purduehackers/door-opener/README.md

# door-opener

🔑 Passport-based access control & door opener for Hack Night.

[Demo](https://youtu.be/31aA09y7xFA)

- [Documentation](./docs/README.md)
