purduehackers/door-opener/docs/hardware/README.md

# Hardware

This directory documents the hardware for `door-opener`.

## [v2](./v2/README.md)

This is the recommended build for `door-opener`. CAD files are
[available here](../../cad/v2/).

## [v1](./v1/README.md)

This is not recommended anymore and kept only for maintenance purposes. If you
need to work on `door-opener-v1`, view this documentation. CAD files are not
available.
