purduehackers/door-opener/docs/hardware/v2/README.md

# door-opener-v2

## External

v2 is comprised of a more simplified design compared to v1, with the back plate
that is designed to slide out entirely. This allows for easier access during
maintenance.

The screw holding the back plate to the enclosure is an M3, with a length of 20
mm. The screw head is a Torx T10.

Once removed, the Raspberry Pi with the touchscreen module should be visible.
The red NFC module should be to the bottom left, and the camera module should be
to the bottom right.

The touchscreen module should be held in with 4x M2.5 screws, 10 mm in length.
The screw head is a Torx T8.

The red PN532 NFC module should be held in with 2x M3 screws, 6.7 mm in length.
The screw head is a Philips PH1.

The camera module should be held in with 4x M2 screws, 5.8 mm in length. The
screw head is a Torx T6.

If building a new enclosure, you should also insert new heat set inserts. The
dimensions are as follows:

- NFC module and back plate standoff: M3, 3 mm height, 3x
- Raspberry Pi camera module standoff: M2, 2.5 mm height, 4x

## BOM

| Name | URL | Notes |
|---|-----|---|
| Raspberry Pi 5 | Anywhere in stock sadly | |
| 5-inch Touchscreen | [Amazon](https://www.amazon.com/dp/B0CXTFN8K9) | |
| PN532 NFC module | [Amazon](https://www.amazon.com/dp/B01I1J17LC) | |
| Raspberry Pi Camera Module 3 12 MP 120 Degree Wide Angle Lens | [Adafruit](https://www.adafruit.com/product/5658) | |
| 3x M3 3 mm Heat Set Insert | | |
| 4x M2 2.5 mm Heat Set Insert | | |
| 1x M3 20 mm screw | | |
| 4x M2.5 10 mm screws | | |
| 2x M3 6.7 mm screws | | |
| 4x M2 5.8 mm screws | | |

Notes:
- Raspberry Pi 5 should be usable with ? GB RAM variant.

## [Assembly Instructions](./assembly.md)
