purduehackers/door-opener/cad/v2/BackPlate_v7.stp

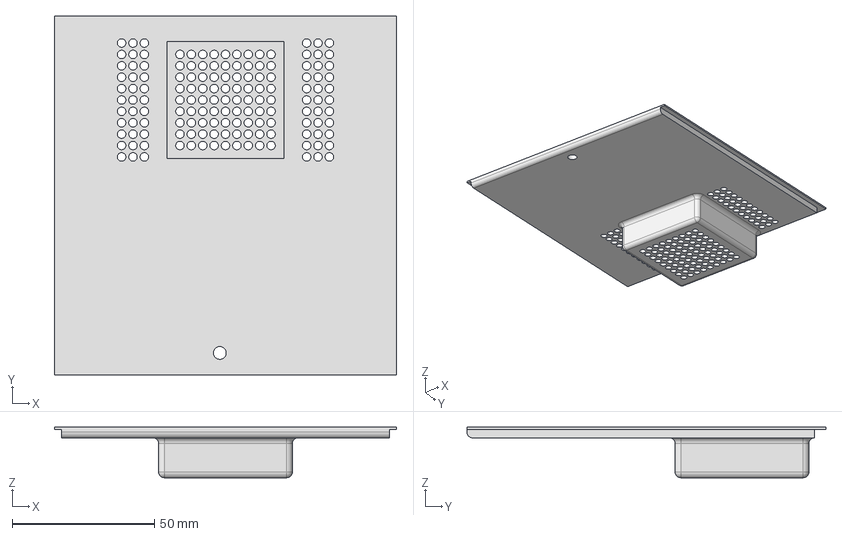
[picture p1: CAD file, 2026-04-21]
cad/v2/BackPlate_v7.stp
120.3 x 126.1 x 17.8 mm
