purduehackers/door-opener/cad/v2/Enclosure_v7.stp

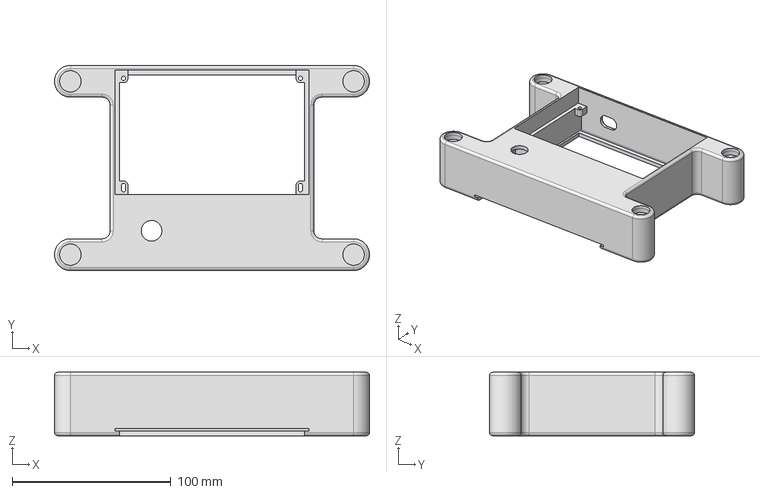
[picture p2: CAD file, 2026-04-06]
cad/v2/Enclosure_v7.stp
198.3 x 129.1 x 40.0 mm
