purduehackers/door-opener/cad/v2/BackPlate_v3.stp

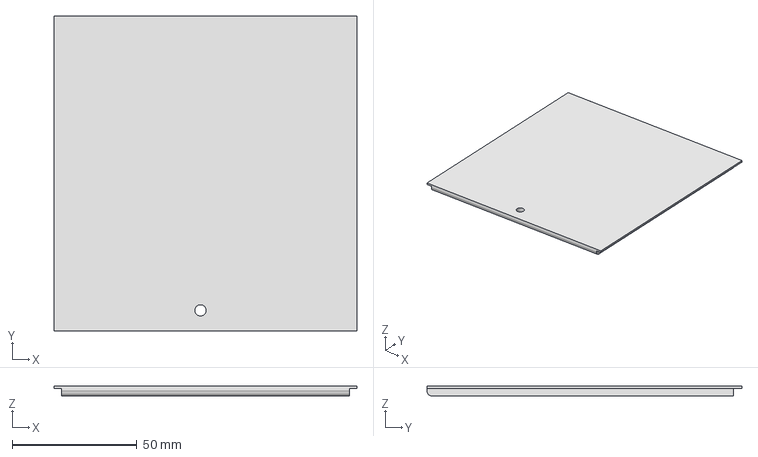
[picture p3: CAD file, 2026-03-07, an earlier design]
cad/v2/BackPlate_v3.stp
121.3 x 126.1 x 4.00 mm
