purduehackers/door-opener/(list of files, cad)

Other CAD files:
cad/v2/Enclosure_v5.stp
cad/v2/Enclosure_v4.stp
cad/v2/BackPlate.ipt
cad/v2/Enclosure.ipt
cad/v2/door-opener-v2-enclosure.iam
cad/v2/door-opener-v2-enclosure.ipt
