purduehackers/door-opener/src/websocket.rs

use std::{env, time::Duration};

use async_tungstenite::tungstenite::Error;
use async_tungstenite::{
    WebSocketSender,
    tokio::{ConnectStream, connect_async},
    tungstenite::{Bytes, Message},
};
use futures::prelude::*;

use tokio::time::sleep;
use tracing::{error, info, warn};

use crate::camera::capture_photo;

#[derive(Debug, serde::Deserialize, serde::Serialize)]
#[serde(tag = "type")]
enum WebSocketMessage {
    Open,
    OpenAck,
    CapturePhoto,
    PhotoResult { data: String },
}

async fn handle_message<F>(
    write: &mut WebSocketSender<ConnectStream>,
    msg: Option<Result<Message, Error>>,
    open: &mut F,
) -> Result<(), ()>
where
    F: FnMut() + Send + 'static,
{
    match msg {
        Some(Ok(Message::Text(t))) => {
            if let Ok(msg) = serde_json::from_str(t.as_ref()) {
                match msg {
                    WebSocketMessage::Open => {
                        open();
                        let res = write
                            .send(Message::Text(
                                serde_json::to_string(&WebSocketMessage::OpenAck)
                                    .unwrap()
                                    .into(),
                            ))
                            .await;
                        if let Err(e) = res {
                            error!(error = ?e, "failed to send open ack");
                        }
                    }
                    WebSocketMessage::CapturePhoto => {
                        let photostring = capture_photo();
                        if let Ok(photostring) = photostring {
                            let res = write
                                .send(Message::Text(
                                    serde_json::to_string(&WebSocketMessage::PhotoResult {
                                        data: photostring,
                                    })
                                    .unwrap()
                                    .into(),
                                ))
                                .await;
                            if let Err(e) = res {
                                error!(error = ?e, "failed to send photo result");
                            }
                        } else {
                            error!(error = ?photostring, "failed to capture photo");
                        }
                    }
                    WebSocketMessage::OpenAck | WebSocketMessage::PhotoResult { .. } => {
                        // We send those and we should never receive them from the server
                        unreachable!("Server sent invalid sender-only packets!");
                    }
                }
            }
        }
        Some(Ok(Message::Ping(_) | Message::Pong(_))) => {}
        Some(Err(e)) => error!(error = ?e, "received websocket error"),
        None => {
            return Err(());
        }
        _ => warn!(message = ?msg, "unsupported websocket message received"),
    }
    Ok(())
}

/// Websocket entry
///
/// # Panics
///
/// Will panic if there is no API key found
pub async fn ws_entry<F>(mut open: F)
where
    F: FnMut() + Send + 'static,
{
    let websocket_url = "wss://api.purduehackers.com/phonebell/door-opener";

    loop {
        let (socket, _resp) = match connect_async(websocket_url).await {
            Ok(x) => {
                info!(url = websocket_url, "connected to websocket");
                x
            }
            Err(e) => {
                warn!(
                    url = websocket_url,
                    retry_in_secs = 5,
                    error = %e,
                    "failed to connect to API websocket; retrying"
                );
                sleep(Duration::from_secs(5)).await;
                continue;
            }
        };

        let (mut write, mut read) = socket.split();

        write
            .send(Message::Text(
                env::var("DOOR_OPENER_API_KEY")
                    .expect("door opener API key")
                    .into(),
            ))
            .await
            .expect("write auth");

        loop {
            tokio::select! {
                () = sleep(Duration::from_secs(25)) => {
                    write.send(Message::Ping(Bytes::default())).await.expect("ping");
                }
                msg = read.next() => {
                    let res = handle_message(&mut write, msg, &mut open).await;
                    if res.is_err() {
                        break;
                    }
                }
            }
        }

        warn!("websocket connection closed");
    }
}
