purduehackers/door-opener/src/updater.rs

#![cfg(not(debug_assertions))]
use std::env;

use std::error::Error;
use tokio::fs::File;
use tokio::io::AsyncWriteExt;

use reqwest::Client;
use semver::Version;
use serde_json::Value;

use self_replace::self_replace;

type Result<T> = std::result::Result<T, Box<dyn Error>>;

/// Checks and performs updates, returns true if an update was performed
pub async fn update_check() -> bool {
    // Get the latest release on GitHub
    let latest_version = Version::parse(
        get_latest_version()
            .await
            .unwrap_or_else(|e| {
                eprintln!("Failed to fetch latest version from GitHub!");
                sentry::capture_error(&*e);
                String::from("0.0.0")
            })
            .as_str(),
    )
    .unwrap();
    let current_version = Version::parse(env!("CARGO_PKG_VERSION")).unwrap();

    // Compare our version string
    if latest_version > current_version {
        println!(
            "We are out of date; the latest version is {} and we are at {}",
            latest_version, current_version
        );
        let update_result = perform_update().await;
        match update_result {
            Ok(()) => {
                println!("Update successful!");
                true
            }
            Err(e) => {
                eprintln!("Update failed: {e}");
                false
            }
        }
    } else {
        println!("No update required; current version is {}", current_version);
        false
    }
}

fn get_client() -> Result<Client> {
    Ok(reqwest::Client::builder()
        .user_agent("door-opener")
        .build()?)
}

/// Gets the latest version number from GitHub
async fn get_latest_version() -> Result<String> {
    let client = get_client()?;
    let response = client
        .get("https://api.github.com/repos/purduehackers/door-opener/releases/latest")
        .send()
        .await?;

    let json: Value = response.json().await?;

    let tag_name = json
        .get("tag_name")
        .ok_or("missing tag_name")?
        .as_str()
        .ok_or("invalid type for tag_name")?
        .to_string();

    Ok(tag_name)
}

fn get_arch_suffix() -> Result<&'static str> {
    match env::consts::ARCH {
        "aarch64" => Ok("aarch64"),
        arch => Err(format!("unsupported architecture: {}", arch).into()),
    }
}

async fn perform_update() -> Result<()> {
    // Where are we?
    let current_executable_path = env::current_exe().unwrap();

    // Grab artifact from latest release matching our architecture
    let arch = get_arch_suffix()?;
    let url = format!(
        "https://github.com/purduehackers/door-opener/releases/latest/download/openerapp_{}",
        arch
    );
    let client = get_client()?;
    let response = client.get(&url).send().await?;
    let artifact = response.bytes().await?.to_vec();

    // Save file temporarily
    let temp_path = current_executable_path.with_extension("tmp");
    let mut temp_file = File::create(&temp_path).await?;
    temp_file.write_all(&artifact).await?;

    self_replace(temp_path)?;

    Ok(())
}
