purduehackers/door-opener/src/enums.rs

#[derive(Debug, Clone, Copy, Eq, PartialEq, Default)]
pub enum AuthState {
    #[default]
    Idle = 0,
    Pending = 1,
    Valid = 2,
    Invalid = 3,
    NetError = 4,
    NFCError = 5,
    DoorHWNotReady = 6,
}
