purduehackers/door-opener/src/gui/passport/mod.rs

use macroquad::prelude::*;

use super::svg;

use super::colors::{BLACK_BG, GREEN_CL, RED_CL, YELLOW_ACCENT};
use crate::AuthState;

const PASSPORT_EMBLEM: &[u8] = include_bytes!("../assets/passport-emblem.svg");
const LOADING_SPINNER: &[u8] = include_bytes!("../assets/loading-spinner.svg");

pub struct PassportData {
    logo_texture: Texture2D,
    loading_spinner_texture: Texture2D,
    current_spinner_colour: Color,
    current_spinner_cutout_opacity: f32,
    current_x: f32,
    current_y: f32,
    last_state: AuthState,
    current_animation_time: f32,
    last_final_x: f32,
    last_final_y: f32,
}

/// Initialize passport data
///
/// # Panics
///
/// Will panic if the textures cannot be loaded
#[must_use]
pub fn initialise_passport() -> PassportData {
    let logo_texture = svg::svg_to_texture(
        String::from_utf8(PASSPORT_EMBLEM.to_vec())
            .unwrap()
            .as_str(),
    );
    let loading_spinner_texture = svg::svg_to_texture(
        String::from_utf8(LOADING_SPINNER.to_vec())
            .unwrap()
            .as_str(),
    );

    PassportData {
        logo_texture,
        loading_spinner_texture,
        current_spinner_colour: YELLOW_ACCENT(255),
        current_spinner_cutout_opacity: 0.0,
        current_x: 0.0,
        current_y: 0.0,
        last_state: AuthState::Idle,
        current_animation_time: 0.0,
        last_final_x: 0.0,
        last_final_y: 0.0,
    }
}

#[allow(clippy::cast_possible_truncation)]
pub fn draw_passport(x: f32, y: f32, state: AuthState, passport_data: &mut PassportData) {
    let delta_time: f32 = get_frame_time();
    let loading_spinner_angle = (get_time() * 3.0) as f32;

    if state != passport_data.last_state {
        passport_data.last_state = state;
        passport_data.current_animation_time = 0.0;
        passport_data.last_final_x = passport_data.current_x;
        passport_data.last_final_y = passport_data.current_y;
    }

    update_passport_position(x, y, state, passport_data);

    passport_data.current_animation_time =
        f32::clamp(passport_data.current_animation_time + delta_time, 0.0, 2.0);

    // Passport box should fit within current screen
    let passport_side_length = screen_width().min(screen_height());
    let inner_passport_side_length = passport_side_length - 20.0;

    draw_rectangle(
        passport_data.current_x - passport_side_length / 2.0,
        passport_data.current_y - passport_side_length / 2.0,
        passport_side_length,
        passport_side_length,
        YELLOW_ACCENT(255),
    );
    draw_rectangle(
        passport_data.current_x - inner_passport_side_length / 2.0,
        passport_data.current_y - inner_passport_side_length / 2.0,
        inner_passport_side_length,
        inner_passport_side_length,
        BLACK_BG(255),
    );

    update_spinner_state(state, delta_time, passport_data);

    draw_texture_ex(
        &passport_data.logo_texture,
        passport_data.current_x - (passport_side_length / 2.0),
        passport_data.current_y - (passport_side_length / 2.0),
        YELLOW_ACCENT(255),
        DrawTextureParams {
            dest_size: Some(vec2(passport_side_length, passport_side_length)),
            ..Default::default()
        },
    );

    draw_loading_spinner(loading_spinner_angle, passport_data);
}

fn update_passport_position(x: f32, y: f32, state: AuthState, passport_data: &mut PassportData) {
    let curved_x = match state {
        AuthState::Idle => None,
        AuthState::Pending => {
            let linear_x = f32::clamp(passport_data.current_animation_time, 0.0, 1.0);
            Some(ease_in_out(linear_x))
        }
        _ => {
            let linear_x = passport_data.current_animation_time - 1.0;
            if linear_x >= 0.0 {
                Some(ease_in_out(linear_x))
            } else {
                Some(0.0)
            }
        }
    };

    if let Some(curve) = curved_x {
        passport_data.current_x = super::float32_lerp(passport_data.last_final_x, x, curve);
        passport_data.current_y = super::float32_lerp(passport_data.last_final_y, y, curve);
    } else {
        passport_data.current_x = x;
        passport_data.current_y = y;
    }
}

fn update_spinner_state(state: AuthState, delta_time: f32, passport_data: &mut PassportData) {
    let target_opacity = if matches!(state, AuthState::Pending) {
        0.0
    } else {
        1.0
    };

    passport_data.current_spinner_cutout_opacity = super::float32_lerp(
        passport_data.current_spinner_cutout_opacity,
        target_opacity,
        delta_time * 10.0,
    );

    let target_colour = match state {
        AuthState::Idle | AuthState::Pending => YELLOW_ACCENT(255),
        AuthState::Valid => GREEN_CL,
        AuthState::Invalid
        | AuthState::NetError
        | AuthState::NFCError
        | AuthState::DoorHWNotReady => RED_CL,
    };

    passport_data.current_spinner_colour = super::colour_lerp(
        passport_data.current_spinner_colour,
        target_colour,
        delta_time * 10.0,
    );
}

fn draw_loading_spinner(loading_spinner_angle: f32, passport_data: &PassportData) {
    let passport_side_length = screen_width().min(screen_height());
    let spinner_center_x = passport_data.current_x - (passport_side_length / 2.0);
    let spinner_center_y = passport_data.current_y - (passport_side_length / 2.0);

    draw_texture_ex(
        &passport_data.loading_spinner_texture,
        spinner_center_x,
        spinner_center_y,
        Color {
            r: passport_data.current_spinner_colour.r,
            g: passport_data.current_spinner_colour.g,
            b: passport_data.current_spinner_colour.b,
            a: passport_data.current_spinner_cutout_opacity,
        },
        DrawTextureParams {
            dest_size: Some(vec2(passport_side_length, passport_side_length)),
            rotation: loading_spinner_angle,
            flip_x: true,
            flip_y: true,
            ..Default::default()
        },
    );

    draw_texture_ex(
        &passport_data.loading_spinner_texture,
        spinner_center_x,
        spinner_center_y,
        passport_data.current_spinner_colour,
        DrawTextureParams {
            dest_size: Some(vec2(passport_side_length, passport_side_length)),
            rotation: loading_spinner_angle,
            ..Default::default()
        },
    );
}

fn ease_in_out(linear_x: f32) -> f32 {
    -2.0 * (linear_x * linear_x * linear_x) + 3.0 * (linear_x * linear_x)
}
