purduehackers/door-opener/(commit log)

2023-12-14 more idiomatic rust in message receiving -- handle all errors
    [mod.rs]
2024-01-13 fixed an nfc connection issue
    [mod.rs]
2024-01-14 implemented proper nfc polling and the LED controller
2024-02-28 some final optimizations and error checking
    [mod.rs]
2024-12-10 Added a tool to interpret LX-16A servo commands on an rp2040-based microcontroller
2025-09-27 fix: use POST instead of GET
    This was changed in https://github.com/purduehackers/id/pull/12
    [mod.rs]
2025-09-27 feat: separate NFC and net error screens
    [mod.rs]
2025-09-27 fix: consume result
    Regression, oops
    [mod.rs]
2025-09-27 fix: temp print out errors
    [mod.rs]
2025-09-27 fix: change variable name
    [mod.rs]
2025-09-27 fix: add content-type header
    [mod.rs]
2025-09-27 fix: update NFC error message
    Too long, overflowed the text box
    [mod.rs]
2025-11-11 fix: enable vendored feature only for nfc1 on Windows
    Default features list includes `drivers`, which we do not need.
2025-11-11 fix: remove lifetimes
    Device no longer takes lifetimes in latest nfc1/nfc1-sys
    [mod.rs]
2025-11-12 fix: cargo clippy suggestions
    [mod.rs, timedvariable.rs]
2025-11-12 fix: remove dead code
    [mod.rs]
2025-11-12 fix: bubble up NFC device open error
    [mod.rs]
2025-11-15 fix: return reqwest error instead of hiding it
    cargo clippy suggestion
    [mod.rs]
2025-11-20 docs(hardware): add v1 screw positions image
2025-11-21 docs(hardware): add NFC module and wiring information
2026-01-23 build: switch to Rust edition 2024
2026-01-23 fix: remove unused ServoEmulator and lib
2026-01-26 fix(gui): remove LED controller comments
    [mod.rs]
2026-01-26 fix: add integer values to the enums for now
    We can remove them once we've gotten rid of all the magic
    numbers in the code
    [enums.rs]
2026-01-26 fix: remove unnecessary default match arm for passport color
    [mod.rs]
2026-01-26 fix: initialize servo controller on move instead of once
    [mod.rs]
2026-02-13 fix: remove unused imports
    grr @ImTheSquid >:(
    [main.rs, mod.rs]
2026-02-13 fix: all cargo clippy warnings
    [main.rs, mod.rs, timedvariable.rs]
2026-02-13 fix: look for nimble BLE devices as well
    for _some_ reason, it advertises as nimble despite us setting the
    ada-pusher name. i don't know why and I can't figure out why right now,
    just patch
2026-02-14 fix: remove unused imports
    [main.rs]
2026-02-14 fix: clean up debug messages
    [mod.rs]
2026-02-14 fix: remove unused import
    [mod.rs]
2026-02-14 fix: remove unnecessary debug messages
    [mod.rs]
2026-02-14 fix: remove tokio init arguments
    Not needed, defaults are fine
    [main.rs]
2026-02-15 fix: visibility of updater
    [updater.rs]
2026-02-15 fix: import and await
    [main.rs]
2026-02-15 fix: properly gate all updater functions behind debug cfg
    [main.rs, updater.rs]
2026-02-18 refactor(gui): repeated error windows
    [mod.rs]
2026-02-18 fix(hardware): gate modules behind features
    [mod.rs]
2026-02-18 fix(hardware): use correct module specified with feature
    [mod.rs]
2026-02-18 refactor(gui): simplified error matching
    [mod.rs]
2026-02-20 fix!: append aarch64 arch name to built binary
    Updater will now look for binary corresponding to the current
    arch, but this is considered a breaking change and we should bump minor
    (0.x)
    [updater.rs]
2026-02-20 feat: retry door hardware init and show error in meantime
    [enums.rs, main.rs, mod.rs]
2026-02-20 fix: retry sending open command on fail
    [mod.rs]
2026-02-20 fix: re-init after multiple failed open attempts
    [mod.rs]
2026-02-21 fix(updater): add user agent to request
    [updater.rs]
2026-02-21 fix: remove unnecessary print
    [updater.rs]
2026-02-21 fix!: remove lx16a code, revert to pre-retry code
    Hotfix for hack night
    [main.rs, mod.rs]
2026-02-21 fix: add more debugging messages
    [mod.rs]
2026-02-21 fix: add updater debug message
    [main.rs]
2026-02-21 fix(updater): more debug messages
    [updater.rs]
2026-02-21 fix: add more debug messages
    [mod.rs]
2026-02-21 fix: actually check result of sending open command
    [mod.rs]
2026-02-21 fix: make blocking threads use spawn_blocking
    [main.rs]
2026-02-21 release: 0.4.6
    Try using separate threads for blocking calls
2026-02-23 fix: cargo clippy with pedantic ruleset
    [main.rs, mod.rs]
2026-02-23 fix: more cargo clippy suggestions
    [main.rs, mod.rs]
2026-02-23 fix: increase ping interval to 25 seconds
    [main.rs]
2026-03-02 fix: cargo clippy nest or pattern
    [main.rs]
2026-03-02 feat: add door-opener-v2 CAD models
    [BackPlate.ipt, Enclosure.ipt, door-opener-v2-enclosure.iam, door-opener-v2-enclosure.ipt]
2026-03-02 feat(cad): add initial v2 enclosure STEP drafts
    [BackPlate.step, Enclosure.step]
2026-03-02 fix: retry websocket connection on fail
    Fixes #16
    [main.rs]
2026-03-02 fix: rename steps in Inventor file
    [door-opener-v2-enclosure.ipt]
2026-03-02 fix(cad): rework enclosure (v2)
    Fixed the following:
    - Wall thickness increased to 3mm for better structural integrity
    - Suction cup nub thickness properly measured with ada-pusher
    [Enclosure.step, Enclosure_v2.stl, door-opener-v2-enclosure.iam, door-opener-v2-enclosure.ipt]
2026-03-04 refactor(cad): bring out screw post dist for RPi screen assembly
    [door-opener-v2-enclosure.ipt]
2026-03-04 fix(cad): shorten screw distance for RPi screen assembly
    69.1 mm -> 67.4 mm
    [door-opener-v2-enclosure.ipt]
2026-03-04 fix(cad): increase screen depth of RPi screen assembly
    11.6 mm to 13.6 mm
    Should help protect screen better in case it is dropped
    [door-opener-v2-enclosure.ipt]
2026-03-04 fix(cad): increase camera offset from front of enclosure
    Otherwise the lens protrudes from the enclosure and will probably
    break if dropped. Use acrylic or tape to prevent dust intrusion
    [door-opener-v2-enclosure.ipt]
2026-03-04 fix(cad): add fillets
    [door-opener-v2-enclosure.ipt]
2026-03-04 fix(cad): export v3
    Changes:
    - Fixed screw post distance in-between for RPi screen assembly
    - Inset RPi screen to protect against drops and cracks
    - Lengthened camera screw posts to not have camera protrude from
    enclosure
    - Added fillets for appropriate edges
    [BackPlate.ipt, BackPlate.step, BackPlate_v3.stl, Enclosure.ipt, Enclosure_v2.stl, Enclosure_v3.stl, door-opener-v2-enclosure.ipt]
2026-03-07 fix: replace updater logic with self_update
    Thanks to @ImTheSquid for the pointer
    [updater.rs]
2026-03-07 fix: bring back module re-init logic from before
    [main.rs, mod.rs]
2026-03-07 fix: unused argument warning in release builds
    [mod.rs]
2026-03-07 release: 0.5.0
    ## Changed
    - Websocket pings and pongs are no longer printed to the console
    - Door module will attempt re-initialization if connection fails
    - Try fixing updater again with self_update crate
    - Updated tokio to v1.50.0
    - Updated uuid to v1.22.0
    - General code cleanup
2026-03-07 fix: cargo clippy lint warnings
    [main.rs, mod.rs]
2026-03-07 fix(cad): give backplate some tolerance and create v3 export
    [BackPlate_v3.stp, door-opener-v2-enclosure.iam, door-opener-v2-enclosure.ipt]
2026-03-09 fix(cad): remove old BackPlate export file
    [BackPlate_v3.stl]
2026-03-09 fix(cad): remove tolerances from display side screw holes
    0.5mm off so the holes were not aligning. Remove them.
    [door-opener-v2-enclosure.ipt]
2026-03-09 fix(cad): offset screw holes of screen from top by 0.1mm
    [door-opener-v2-enclosure.ipt]
2026-03-09 docs(hw): finalize back plate screw dimensions
2026-03-09 fix: remove QR code and QR pointer
    We no longer use the doorbell and use phone bell instead
    [mod.rs]
2026-03-09 fix: add feature flag for NFC reader
    [mod.rs]
2026-03-09 fix: gate ada_pusher behind feature flag
    Having a dummy door module makes testing easier
    [mod.rs]
2026-03-09 fix(gui): update message to pick up phone bell
    [mod.rs]
2026-03-09 fix(gui): remove useless margins for all text
    We don't show the QR code anymore, so remove the useless
    hardcoded text margins
    [mod.rs]
2026-03-10 fix(gui): replace hardcoded values with const hardcodes
    Next step would be to remove them
    [mod.rs]
2026-03-10 fix(gui): tweak phone bell message
    [mod.rs]
2026-03-10 fix: allow for possible truncation for width and height
    [mod.rs]
2026-03-11 fix(cad): shorten RPi display assembly standoff depth
    Screws are 10 mm long, and the standoffs on the display assembly
    itself is 3.8 mm, so it should be 6.2 mm for it to reach properly.
    [door-opener-v2-enclosure.ipt]
2026-03-11 fix(cad): add tolerance to back plate cavity
    [door-opener-v2-enclosure.ipt]
2026-03-11 fix(cad): shorten distance between USB-C port and screen
    Shortened by 1 mm so that USB C fits better
    [door-opener-v2-enclosure.ipt]
2026-03-11 fix(cad): Enclosure v4 export
    STEP again because I don't like STL
    [Enclosure_v3.stl, Enclosure_v4.stp]
2026-03-22 fix(gui): use screen_width() returned by macroquad
    [mod.rs]
2026-03-22 fix(gui): hardcode window sizes
    screen_width() and screen_height() fetches from the window size, but if we
    specify that as the initial values then of course macroquad will crash...
    [mod.rs]
2026-03-22 fix(gui): use full screen and remove hardcoded window size
    [mod.rs]
2026-03-22 fix(cad): actually run updates on enclosure after changes
    [Enclosure.ipt]
2026-03-22 fix(cad): re-export Enclosure_v4
    Old version was actually v3 re-export because Inventor didn't
    update the child/reference file properly, oops
    [Enclosure_v4.stp]
2026-03-26 fix(cad): reduce RPi display mount holes by 2 mm
    4.5 mm -> 2.5 mm
    We weren't accounting for the fact that the actual display
    cutout sketch from the front uses the full size of the display,
    which has margins on the side. Thus the screw holes will not
    align.
    [door-opener-v2-enclosure.ipt]
2026-03-26 fix(cad): reduce RPi display screw post depth by 3.5 mm
    6.2 mm -> 2.7 mm
    Was too long, no screw thread at all that goes into the actual
    RPi display screw posts
    [door-opener-v2-enclosure.ipt]
2026-03-26 fix(cad): increase side and bottom tolerance for back plate
    2x the side tolerances (each) from 0.5 mm to 1 mm
    2x the bottom tolerance from 0.25 mm to 0.5 mm
    Top tolerance remains unchanged
    [door-opener-v2-enclosure.ipt]
2026-03-26 fix(cad): increase RPi camera standoff thickness by 2 mm
    1 mm -> 3 mm
    Should help with it not warping while inserting heat set inserts
    [door-opener-v2-enclosure.ipt]
2026-03-26 fix(cad): update derived part files
    [BackPlate.ipt, Enclosure.ipt]
2026-03-26 fix(cad): export v2 HW revision v5
    - Increased tolerance for back plate
    - RPi display mount assembly screw posts shortened
    - RPi display mount assembly screw side distance adjusted
    - Increased diameter for RPi camera mount assembly screw to
    prevent warping when inserting heat set inserts
    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
    [BackPlate_v5.stp, Enclosure_v5.stp]
2026-03-27 fix(cad): offset RPi screen screw holes from top by 2 mm
    Forgot that the side length also takes away from the top of the
    screen. Oops
    [door-opener-v2-enclosure.ipt]
2026-03-27 fix(cad): add anchor to bottom screw mounts of RPi display
    Should help it not shear off if dropped and also add some
    structural support
    [door-opener-v2-enclosure.ipt]
2026-03-27 fix(cad): export Enclosure_v6
    [Enclosure.ipt, Enclosure_v6.stp]
2026-03-31 docs(hw/v2): document touchscreen screw size
2026-04-02 docs: document v2 HW assembly process
2026-04-02 docs: document screw and heat set insert sizes
2026-04-03 fix: explicitly catch no device found error
    This isn't an issue with `door-opener`, you're probably wiring
    it up wrong *wink*
    [mod.rs]
2026-04-06 fix(cad): make RPi display screw holes adjustable
    Increased diameter of inner screw hole, and made the bottom
    screw holes adjustable by giving vertical leeway. We just need to
    have the display sit within the enclosure securely, so the
    vertical spacing should not matter.
    [door-opener-v2-enclosure.ipt]
2026-04-06 fix(cad): make back plate screw depth longer
    Decreased screw length from 20 mm to 8mm
    If the screw depth is too within the enclosure it is hard to
    screw in, and we have M3 screws that are shorter.
    [door-opener-v2-enclosure.ipt]
2026-04-06 fix(cad): export Enclosure_v7
    - Allow for bigger tolerance in RPi display mount screw holes
    - Back plate screw depth changed to a shorter screw for easier
    assembly
    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
    [Enclosure.ipt, Enclosure_v6.stp, Enclosure_v7.stp]
2026-04-08 fix: capture error when GitHub version fetch fails
    [updater.rs]
2026-04-08 fix(gui): make message boxes scale to device screen height
2026-04-08 fix(gui): make passport scale to device screen dimensions
    [mod.rs]
2026-04-08 fix(gui): try scaling down passport texture
    [mod.rs]
2026-04-08 fix(gui/passport): remove unused import
    Somehow snuck in there, oops
    [mod.rs]
2026-04-08 fix(gui/passport): use Default::default() for default values
    [mod.rs]
2026-04-08 fix(gui): draw passport based on screen dimensions
    [mod.rs]
2026-04-21 fix(cad): revise back plate with fan cavity
    Now back plate is v6, enclosure is v7
    Haha funny number geddit?
    [BackPlate.ipt, BackPlate_v5.stp, BackPlate_v6.stp, door-opener-v2-enclosure.ipt]
2026-04-21 fix(cad): add intake holes
    v7 export
    [BackPlate.ipt, BackPlate_v6.stp, BackPlate_v7.stp, door-opener-v2-enclosure.ipt]
2026-04-25 fix: send back OpenAck after receiving Open packet
    [websocket.rs]
2026-04-25 feat: camera capture via websocket
    Send a capture command over websocket and receive back the image
    in base64-encoded AVIF format!
2026-04-25 fix(websocket): add note about unreachable websocket messages
    [websocket.rs]
2026-04-25 fix(websocket): do not end websocket connect attempt if init fails
    Instead, it now waits 5 seconds before trying again
    [websocket.rs]
2026-04-25 fix: switch over to tracing for logging
    [main.rs, websocket.rs]
2026-04-28 fix: linting about duration units
    [mod.rs]
2026-08-14 fix: build Sentry options according to 0.49.0 change
    [main.rs]
2026-08-14 fix: provide default for release name
    [main.rs]
